niw/nodemcu_air_quality_sensor/Resources/Prometheus_Grafana.png

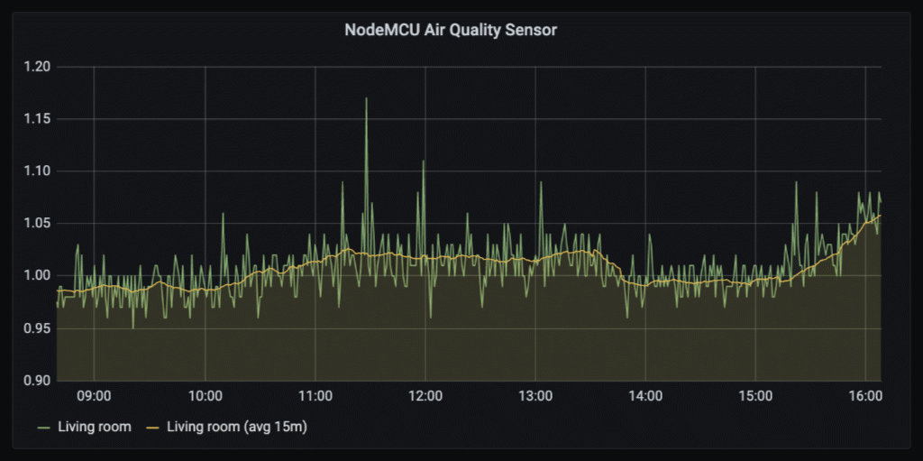
Resources/Prometheus_Grafana.png
